cy384/atreus_bluetooth/(list of files, cad)

Other CAD files:
atreus_dxf_quarters.scad
